sergio-isidoro/PUFA/Projeto_completo_IMG-video.png

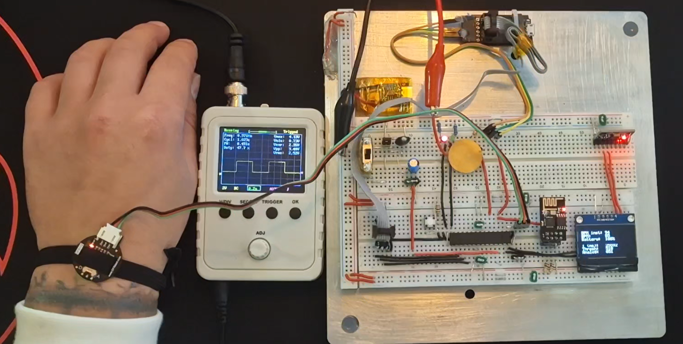
Projeto_completo_IMG-video.png
