sergio-isidoro/PUFA/oledsh1106.jpg

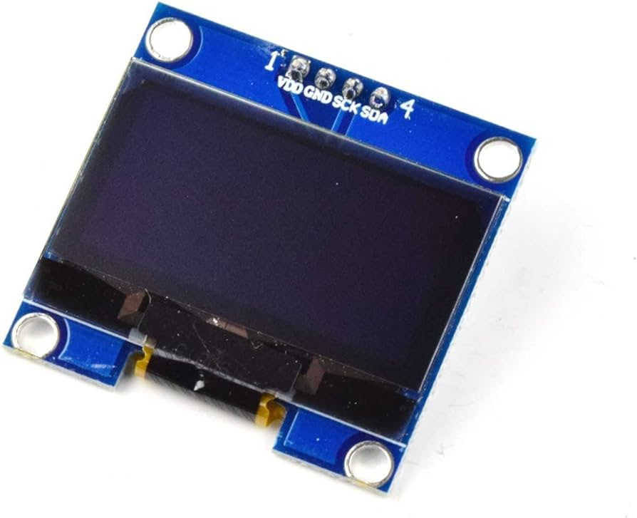
oledsh1106.jpg
