sergio-isidoro/PUFA/README.md

# 🔥 PUFA

yet to be described!

## Screenshot's

Arquitectura
Circuito
Captura de tela 2025-01-09 114456
PCB_FRONT
PCB_BACK

## Photos

Projeto_completo

## Video

https://github.com/user-attachments/assets/bb75e299-b183-4e6a-995e-6fe85692a9c1

## Github link

[PUFA](https://github.com/manoper93/PUFA)
