sergio-isidoro/PUFA/battery.pdf

09/12/2021

1

1

## POWER SUPPLY ALTERNATIVES IN ELECTRONIC SYSTEMS

Systems Laboratory (LABSI)

December 2021

Lino Sousa

LABSI – Systems Laboratory

2

## Summary

### 1. Introduction

### 2. Battery characteristics

### 3. SOC estimation

### 4. Battery technologies

### 5. Power management

LABSI – Systems Laboratory

2

3

## Summary

### 1. Introduction

### 2. Battery characteristics

### 3. SOC estimation

### 4. Battery technologies

### 5. Power management

LABSI – Systems Laboratory

## Introduction

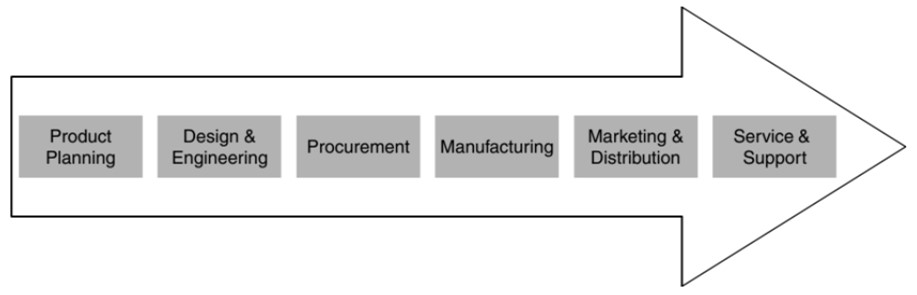
[picture p26: figure]

## Design and development of electronic mobile devices

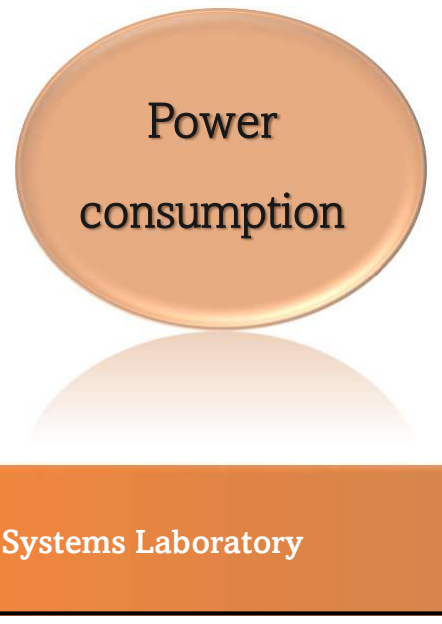
[picture p27: figure]
Power consumption
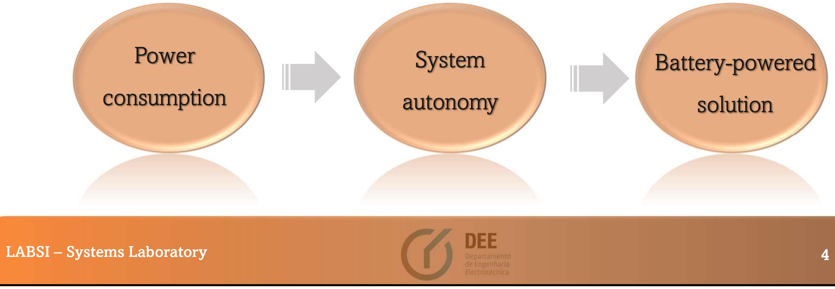
[picture p28: figure]
LABSI – Systems Laboratory; System autonomy; Battery-powered solution
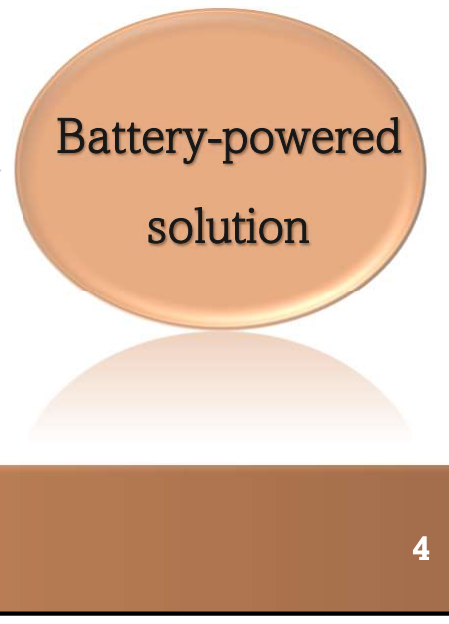
[picture p29: figure]

3

LABSI – Systems Laboratory | 5

## Introduction

## Power Budget

Determines where all the
possible power will be used by a device by breaking it down into components and categories
Components | Voltage | Current | Power | Qt. | Total Power
Atmega 328 | 5 V | 16 mA | 80 mW | 2 | 160 mW
LED | 2 V | 8 mA | 16 mW | 4 | 64 mW
DS18S20 Digital Termometer | 5 V | 2 mA | 10 mW | 1 | 10 mW
APC220 Wireless Radio Module | 5 V | 30 mA | 150 mW | 1 | 150 mW
GY87 Inertial Measurement Unit | 5 V | 4 mA | 20 mW | 1 | 20 mW
DHT11 Humidity Sensor | 5 V | 3 mA | 15 mW | 1 | 15 mW
SD-Card Module | 5 V | 50 mA | 250 mW | 1 | 250 mW
OV7670 CMOS Camera | 3 V | 20 mA | 60 mW | 1 | 60 mW
BMP180 Altitude Sensor | 2,5 V | 2 mA | 5 mW | 1 | 5 mW
GPS Module | 3,3 V | 70 mA | 231 mW | 1 | 231 mW
Total | – | 205 mA | 837 mW | 14 | 965 mW

Example for a drone module with • Position/attitude tracking and

control • Environment data acquisition

Total current: 245 mA

LABSI – Systems Laboratory | 6

## Introduction

## Calculating battery capacity

Power Budget | Current | Power | Qt. | Total Power
Total | 245 mA | 837 mW | 13 | 965 mW

Maximum current consumption over a period of time

C = I × t

- Our system has a maximum current consumption of I
- We want the system to run for t hours straight. • We can then obtain the battery

minimum capacity in Ampere ∙ hour

If we want our system to continuously run for 40 hours, the battery minimum capacity comes:
C = 0,245 × 40 = 9,8 A∙h

Previous application example (Drone Module)

4

LABSI – Systems Laboratory | 7

## Introduction

## Calculating battery capacity

What if the power consumption is not constant ?

I = 20 ×

1
3600 + 0,5 ×

3599
3600 = 0,505 A
- Determine the average current or power consumption per hour • Consider a repetitive cycle of 1 hour

Example: a system has a current consumption of

### 20 A in the first second, and 0,5 A for the rest of

the hour. The average current consumption is:

LABSI – Systems Laboratory | 8

## Introduction

## Calculating battery capacity

Battery lifecycle considerations

C

=

C
0,8
- It is not advised to completely discharge a battery during a cycle • Example: a lead acid battery charge should never be less than

20% of the total charge, to increase its life-cycle • However, some battery technologies, such as NiCd can be

discharged to 100%

5

9

## Summary

### 1. Introduction

### 2. Battery characteristics

### 3. SOC estimation

### 4. Battery technologies

### 5. Power management

LABSI – Systems Laboratory

10

## Battery Characteristics

LABSI – Systems Laboratory

Capacity • Capacity is a measure of the battery charge in Amp ∙ h • Represents the maximum amount of energy that can be extracted from the battery in a specific time interval • Installing a battery with a higher capacity results in a longer runtime, affecting the system’s autonomy • The charging time of a battery with high capacity will take longer that a battery with lower capacity

### 1 Coulomb = 1 A s

6

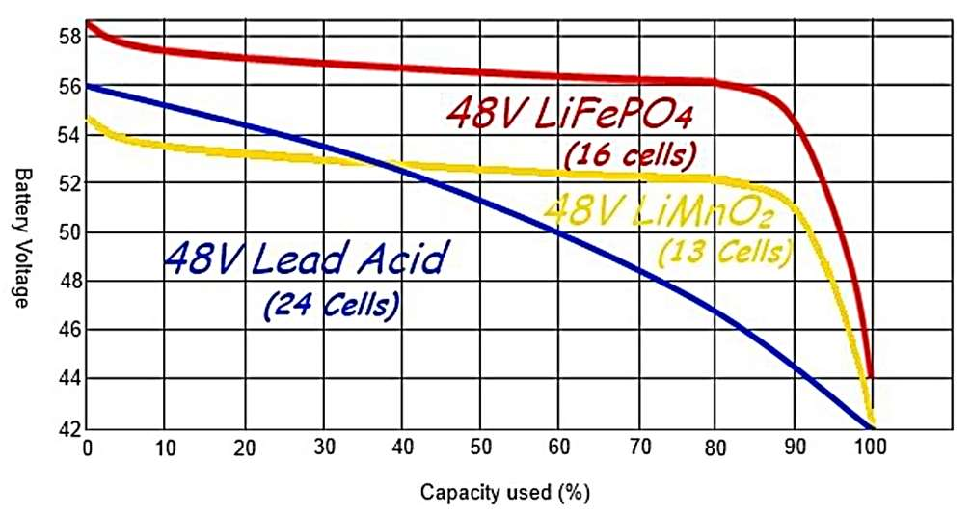
[picture p30: figure]

11

## Battery Characteristics

LABSI – Systems Laboratory

Nominal Voltage • Nominal voltage is determined by

chemical reactions that involve the flow of electrons from one material (electrode) to another • This flow of electrons generates an

electrical current • The battery voltage is a function that

changes with the charge level, meaning that the nominal voltage should always be checked before connecting the battery

Battery voltage curve for: • Lead Acid Batteries • Lithium Iron Phosphate Batteries • Lithium Manganese Dioxide Batteries

12

## Battery Characteristics

LABSI – Systems Laboratory

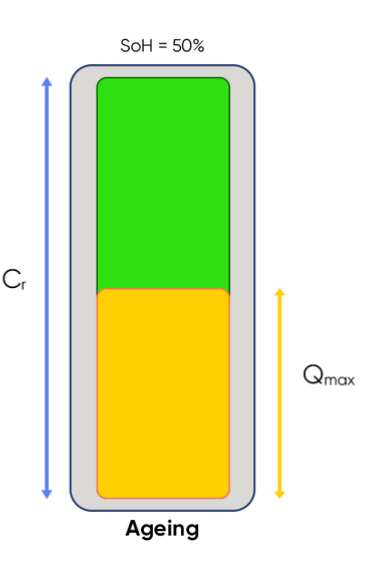
[picture p31: figure]

## State of Health – SoH

- The SoH of a battery describes the difference between a battery being studied and a fresh battery. • It considers the cell aging parameter. • It is defined as the ratio of the maximum battery

charge to its rated capacity

7

13

## Battery Characteristics

LABSI – Systems Laboratory

State of Charge – SoC • The SoC of a battery describes the difference between

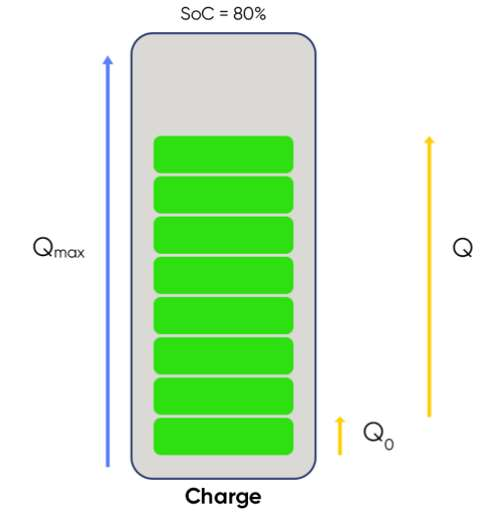
[picture p32: figure]

a fully charged battery and the same battery in use • It is associated with the remaining quantity of

electricity available in the cell • It is defined as the ratio of the remaining charge in the

battery, divided by the maximum charge that can be delivered by the battery.

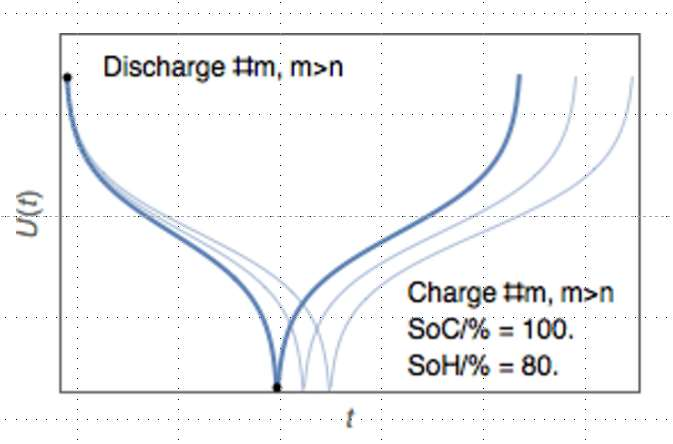
[picture p33: figure]

14

## Battery Characteristics

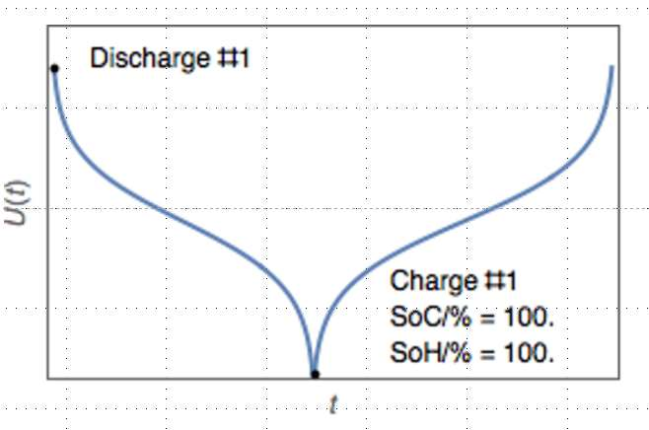
[picture p34: figure]

LABSI – Systems Laboratory

SoC and SoH relation • The discharge profile of a secondary battery is affected by its state of health • The lower the SoH, the faster the battery is discharged/charged

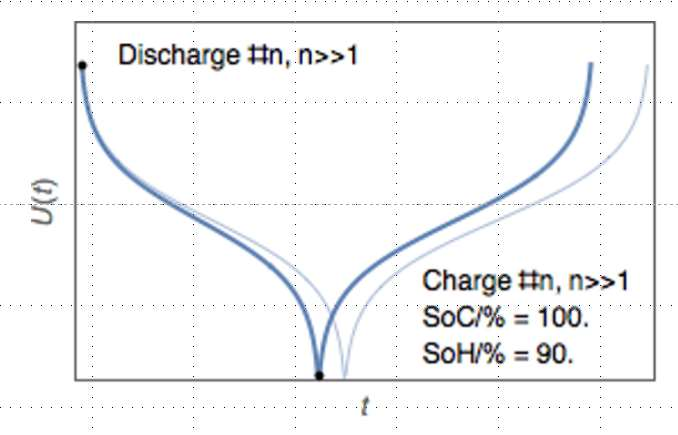
[picture p35: figure]

8

15

## Battery Characteristics

LABSI – Systems Laboratory

## Charging / Discharging rates

Represent the battery capacity as a function of the time in which it takes to fully discharge or charge the battery

The notation to specify battery capacity in this way is written as Cx, where x is the time in hours that it takes to discharge the battery

Cx

Example:

- C20 battery (or 0.05C)
- Capacity of 500 Ah

Discharge rate:

500 Ah / 20 h = 25 A

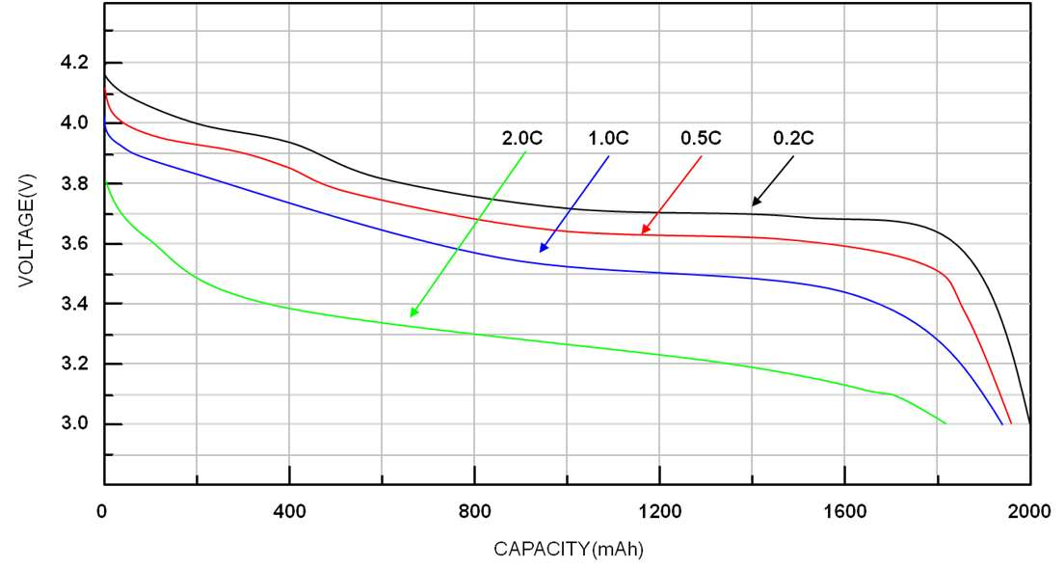
[picture p36: figure]

16

## Battery Characteristics

LABSI – Systems Laboratory

Charging / Discharging rates • Flat discharge curves: the battery

voltage remains constant throughout the discharge cycle • Sloping discharge curves: the battery

voltage is closely related to the remaining charge in the cell • Flat discharge curves require more

complex methods of estimating SoC

Discharge curves for a Li-ion battery

9

17

## Battery Characteristics

LABSI – Systems Laboratory

Self-discharge • Even in the absence of a connected load, the

discharge reaction will proceed to a limited extent • This means the battery will discharge itself

over time • The self-discharge rate depends on: o The materials involved in the chemical

reaction o The temperature of the battery

Battery | Self-discharge
Lithium metal | 10 years
Alkaline | 5 years
Zinc–carbon | 2–3 years
Lithium-ion | 2–3% per month
Lithium-polymer | 5% per month
Lead–acid | 4–6% per month
Nickel–cadmium | 15–20% per month
Nickel–metal hydride (NiMH) | 30% per month

Typical self-discharge by battery type

18

## Battery Characteristics

LABSI – Systems Laboratory

Battery lifetime • Involves gradual degradation in battery capacity • Typically given as the number of charge/discharge cycles which it

can undergo and still maintain its original capacity • In systems such as in uninterruptable power supplies, battery lifetime

### is more appropriately specified in years

10

19

## Summary

### 1. Introduction

### 2. Battery characteristics

### 3. SOC estimation

### 4. Battery technologies

### 5. Power management

LABSI – Systems Laboratory

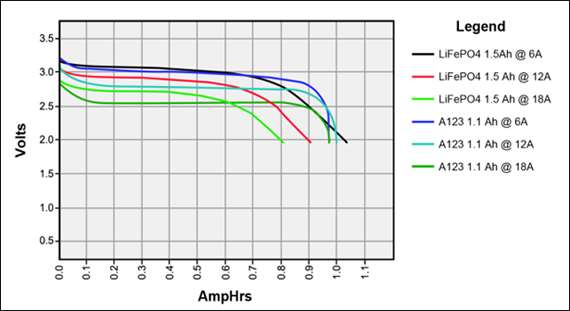
[picture p37: figure]

20

## SoC Estimation

LABSI – Systems Laboratory

## Voltage Method

Measuring state-of-charge by voltage is the simplest method, but it can be inaccurate

The battery needs to rest in the open circuit
state for at least four hours

Some discharge curves are very flat during approximately 80% of the discharge.

Cell materials and temperature affect the voltage at the battery terminals

Li-phosphate (LiFePO) batteries discharge profile

11

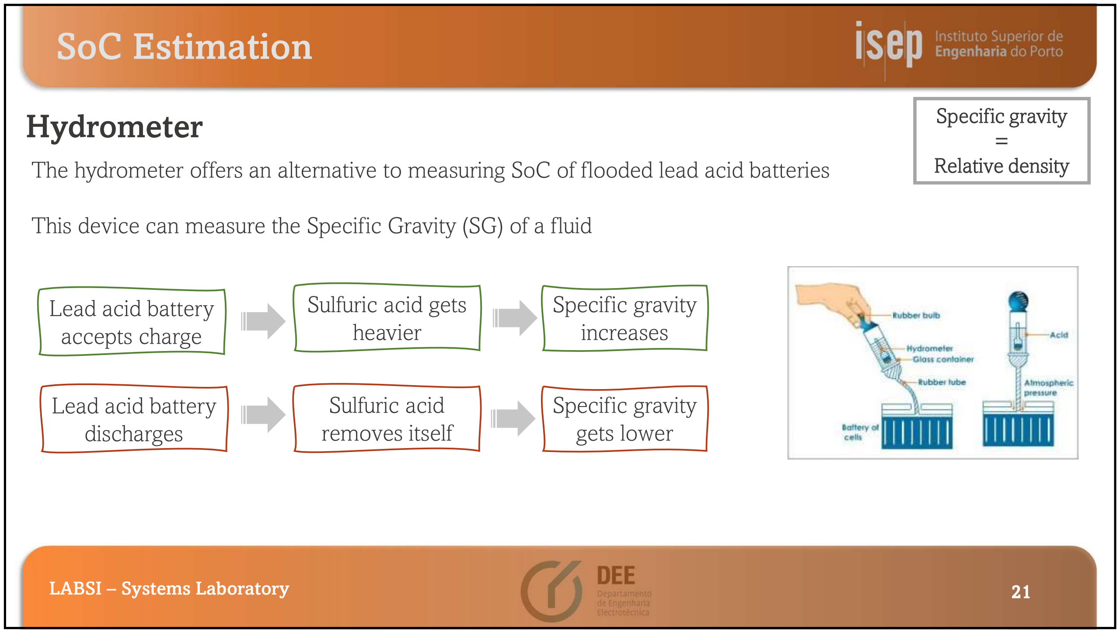
[picture p38: figure]
SoC Estimation; LABSI – Systems Laboratory; Hydrometer; Lead acid battery accepts charge; Sulfuric acid gets heavier; Specific gravity increases; Specific gravity =; Relative density; Lead acid battery discharges; Sulfuric acid removes itself; Specific gravity gets lower

The hydrometer offers an alternative to measuring SoC of flooded lead acid batteries

This device can measure the Specific Gravity (SG) of a fluid

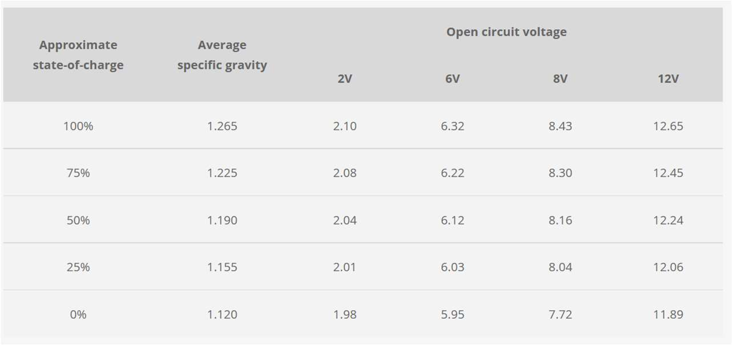
[picture p39: figure]

22

## SoC Estimation

LABSI – Systems Laboratory

## Hydrometer

Temperature alters the
specific gravity reading

The electrolyte needs to
stabilize after charge/discharge before taking the SG reading

The SG of the same battery in full charge or discharge may vary from 1.270 to 1.305 and 1.097 to 1.201 respectively

12

23

## SoC Estimation

LABSI – Systems Laboratory

Coulomb counting • Coulomb counting estimates SoC

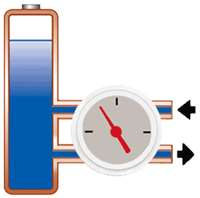
[picture p40: figure]

by measuring the in-and-out-flowing current • This method is used by most

laptops, medical equipment and other professional portable devices to estimate SoC • How it works: a circuit measures

the in-and-out flowing energy; the stored energy represents state-of-charge

Since losses occur, the available energy is always less than what has been fed into the battery

Requires periodical calibration to estimate how much energy the battery delivered during previous discharge

24

## SoC Estimation

LABSI – Systems Laboratory

## So, how do we exactly now I much battery we have left ?

### Short answer: We don’t … Nothing in the battery world is absolute

We can combine this methods and
create algorithms in order to efficiently
estimate the battery state-of-charge | • Kalman Filtering • Pressure method • Electrical Impedance Spectroscopy • Neural Networks • Support Vector Machines
Solution | Other methods:

13

25

## Summary

### 1. Introduction

### 2. Battery characteristics

### 3. SOC estimation

### 4. Battery technologies

### 5. Power management

LABSI – Systems Laboratory

26

## Battery Technologies

LABSI – Systems Laboratory

## General considerations

The most common battery technologies are: • Lead Acid (PbAc) • Nickel-cadmium (NiCd) • Nickel-Metal Hydrite (NiMH) • Lithium Polymer (LiPo)

Most of these rechargeable batteries show a voltage level of 10 to 15 % superior to the nominal voltage when fully charged

Warning:

Series/parallel disposal of batteries result in different voltage levels and capacities. • Lead Acid: 2 V per cell • NiCd and NiMh: 1,2 V per cell • LiPo and Li-Ion: 3,7 V per cell

Multiple batteries are often combined to produce desirable voltage levels or higher capacities

14

27

## Battery Technologies

LABSI – Systems Laboratory

## Battery comparison

Lead Acid | NiCd | NiMH | LiPo • Usually found in cars, boats,

solar energy systems • Large and heavy • Highest capacities: 5 – 150 Ah • Typically available in 6, 8, 12

and 24 V • Solution for electronics: deep-

cycle and sealed batteries

- Usually applied as supply to small electrical motors • Long lifetime with thousands

of charging cycles • High self-discharging rate • Low energy density • Not suitable for mobile

devices

- High capacity 1 – 4
Ah for its size • Fairly high self-

discharging rate • High energy

density • Used in mobile

devices

- One of the most recent
technologies • High energy density • Flexible in size and shape for

a variety of applications • High capacity up to 5Ah • Require specific cautions to

avoid overheating

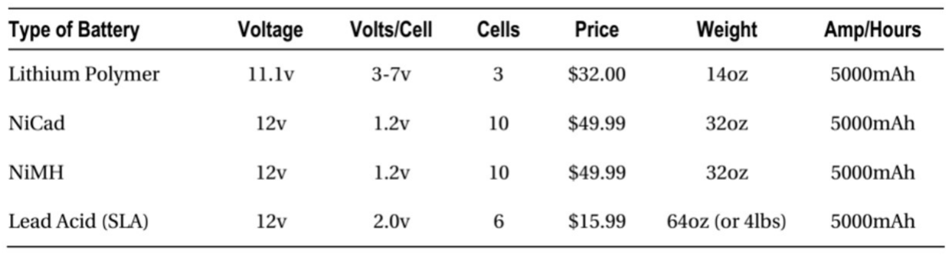
[picture p41: figure]
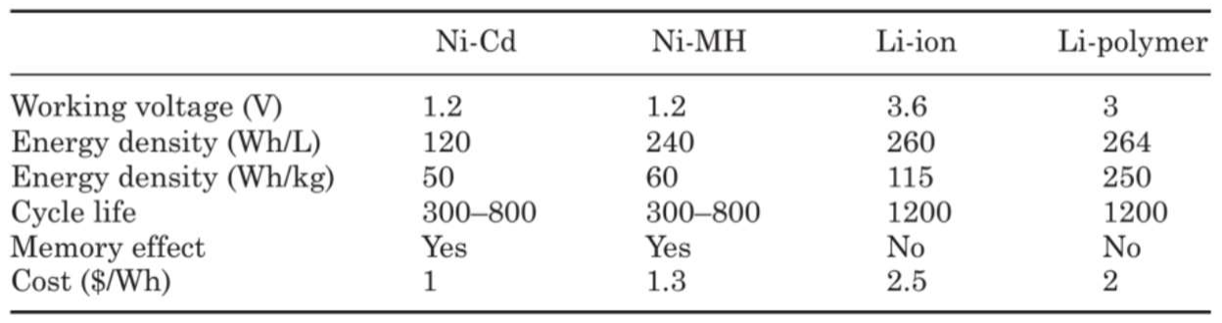
[picture p42: figure]

28

## Battery Technologies

LABSI – Systems Laboratory

## Battery comparison

- LiPo batteries have the highest energy density • Lead acid batteries are the cheapest • NiCd and NiMH are suitable for

most electronic projects • LiPo batteries are the lightest

Each battery technology has its own advantages depending on the application

15

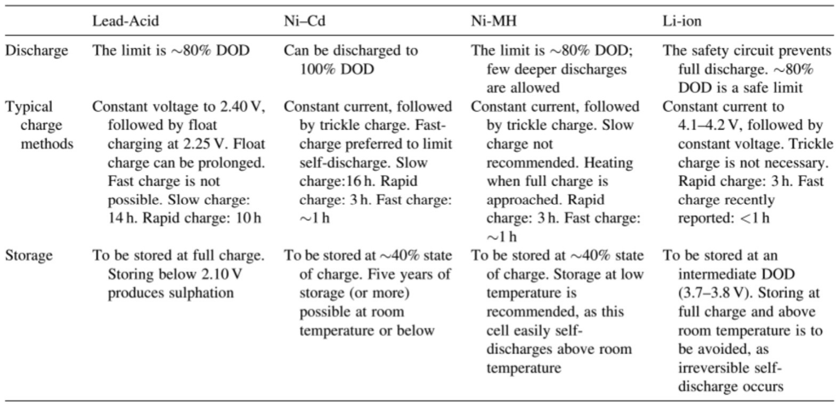
[picture p43: figure]

29

## Battery Technologies

LABSI – Systems Laboratory

## Battery comparison

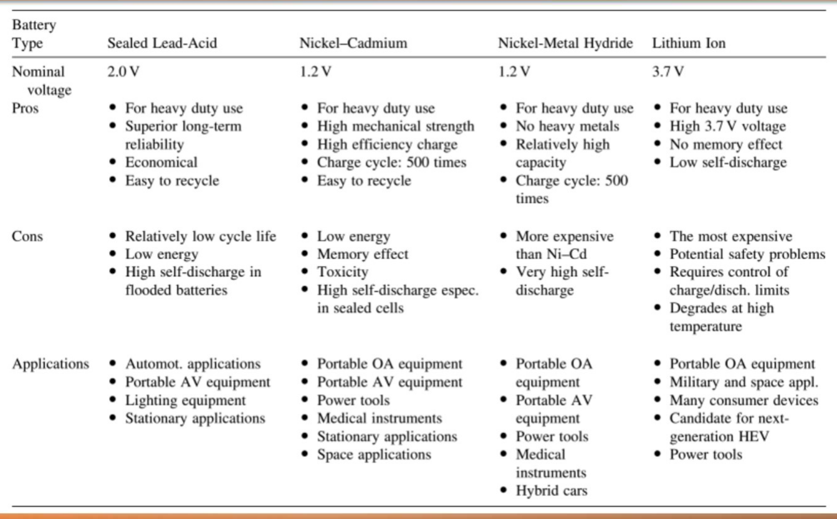
[picture p44: figure]

30

## Battery Technologies

LABSI – Systems Laboratory

## Battery comparison

16

31

## Summary

### 1. Introduction

### 2. Battery characteristics

### 3. SOC estimation

### 4. Battery technologies

### 5. Power management

LABSI – Systems Laboratory

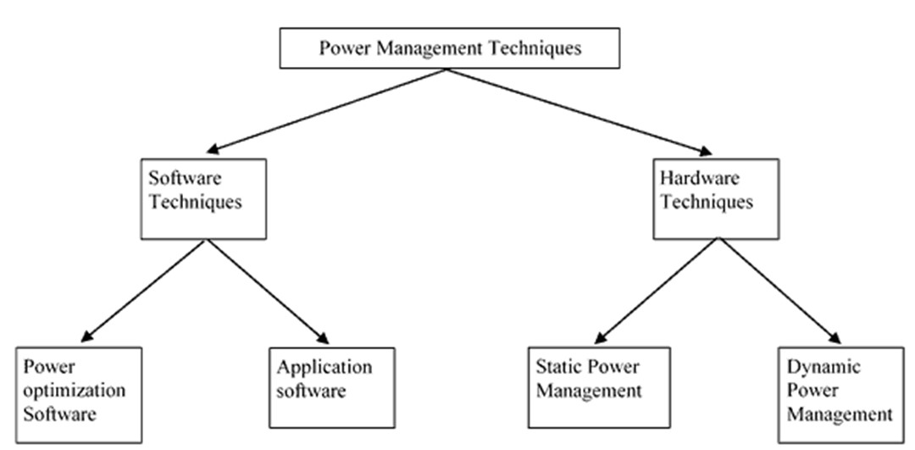
[picture p45: figure]

32

## Power management

LABSI – Systems Laboratory

## Power management

Process of controlling power use in a system by hardware or software

- Battery life improvement
- System’s autonomy increase
- Better thermal behaviour
- Noise reduction
- Improved reliability (better MTBF)

MTBF: Mean time between failure

17

33

## Power management

LABSI – Systems Laboratory

## Power management techniques

Dynamic voltage and
frequency scaling
Automatic adaption of
CPU | frequencies | and
voltages according to the
system load.
The lower the frequency of operation, the lower the
power consumption

Peripheral Power-down

Peripherals and subsystems may be switched on and off
by | the | software, | as
required.
This applies to TIMERs,
ADCs, SPI, I2C and similar components

Low power modes
When a device is not in use, it may be switched to a low power state: • Standby: The CPU and peripherals are

shut down, but power is maintained. Wakes up faster. • Hibernate: The system is shut down and

Timers are disabled. CPU has nothing to run, so there is no ongoing power drain

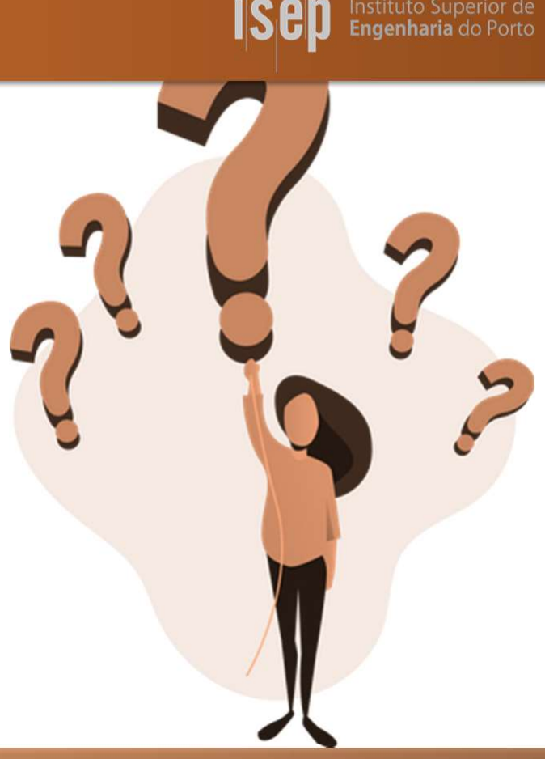
[picture p46: figure]

34

## Questions

LABSI – Systems Laboratory

# Thank you

# For your attention
