sergio-isidoro/PUFA/atmega328p.png

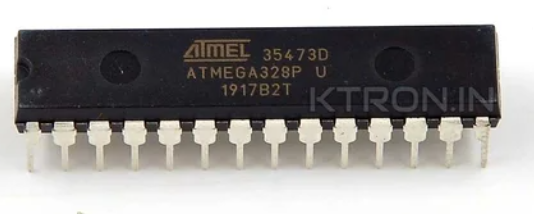
atmega328p.png
