sergio-isidoro/PUFA/Atmega328p_pinout.png

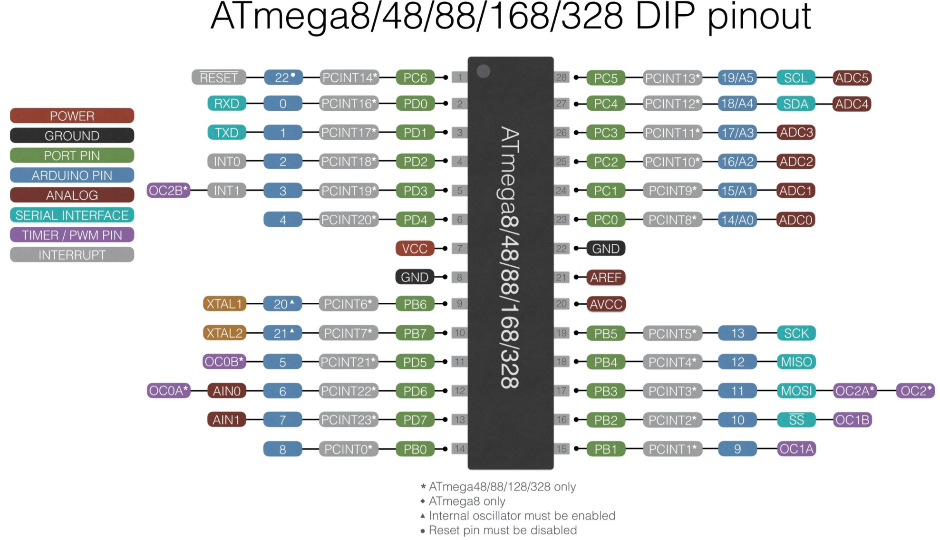
Atmega328p_pinout.png
