sergio-isidoro/PUFA/bateria-recarregavel-li-po-3-7v-1200mah.jpg

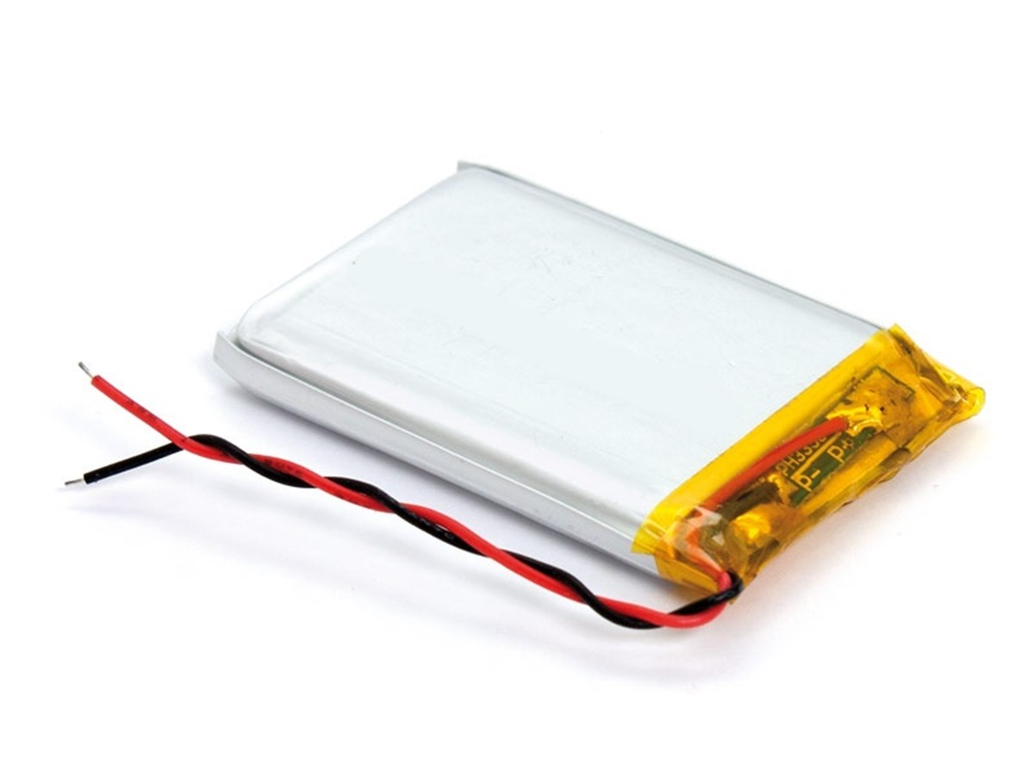
bateria-recarregavel-li-po-3-7v-1200mah.jpg
