sergio-isidoro/PUFA/buzzer-piezo.jpg

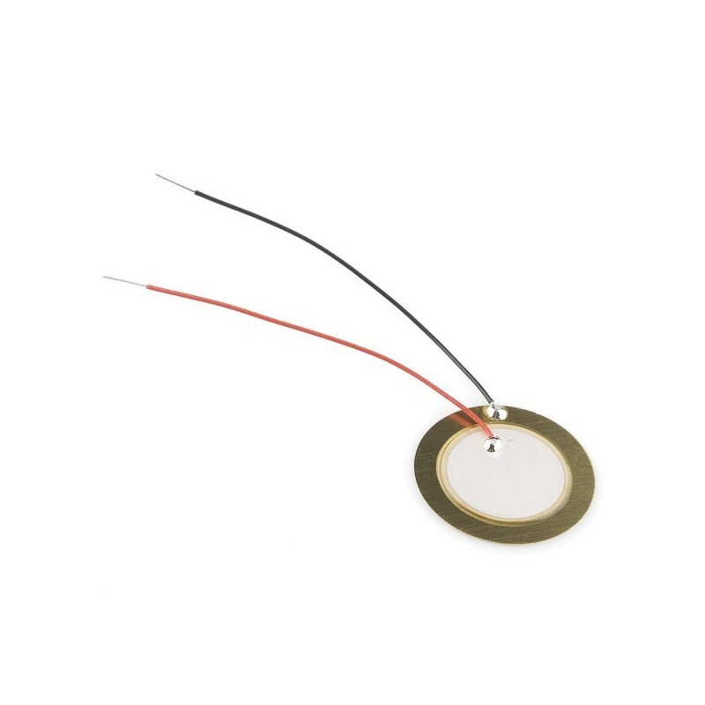
buzzer-piezo.jpg
