sergio-isidoro/PUFA/circuito.png

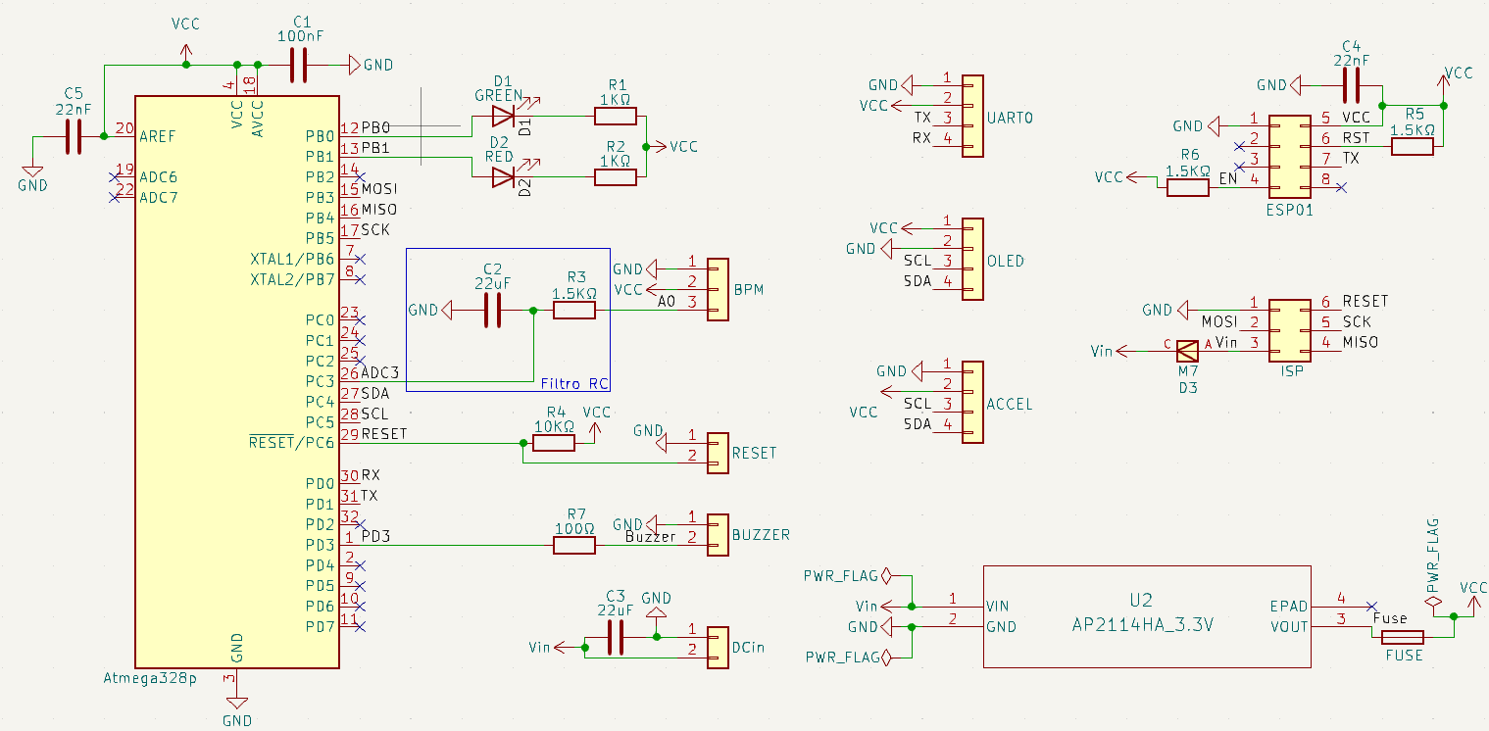
circuito.png
