sergio-isidoro/PUFA/circuito_regulador.png

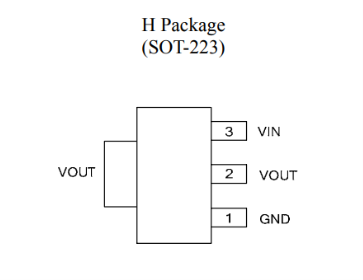
circuito_regulador.png
