sergio-isidoro/PUFA/cyplus.png

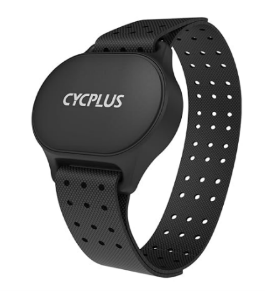
cyplus.png
