sergio-isidoro/PUFA/esense.png

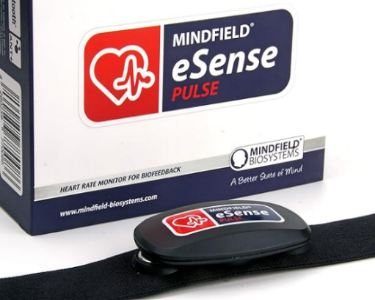
esense.png
