sergio-isidoro/PUFA/Filtro_RC_ADC.jpg

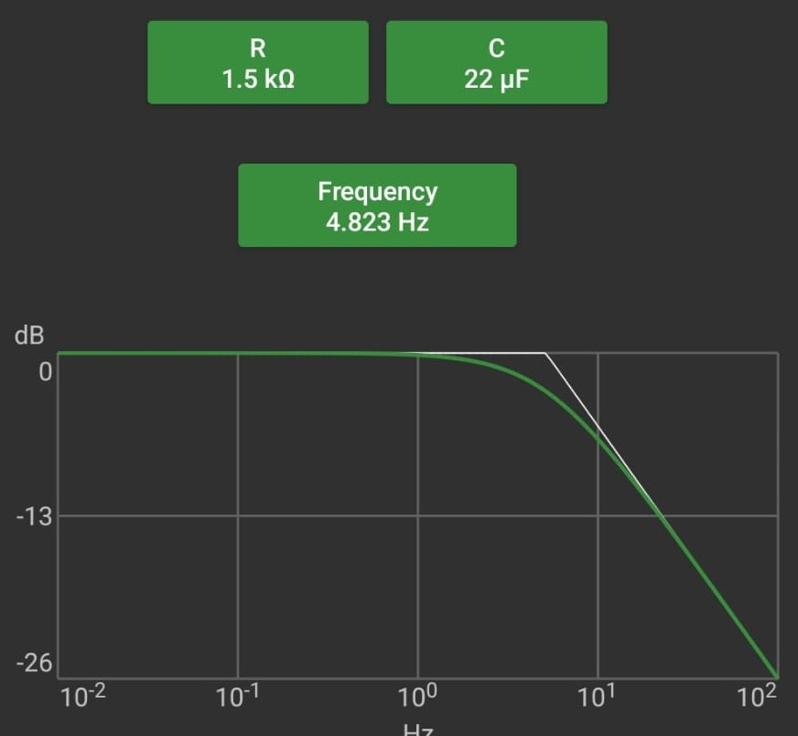
Filtro_RC_ADC.jpg
