sergio-isidoro/PUFA/Fluxograma_Software_Apresnetação.png

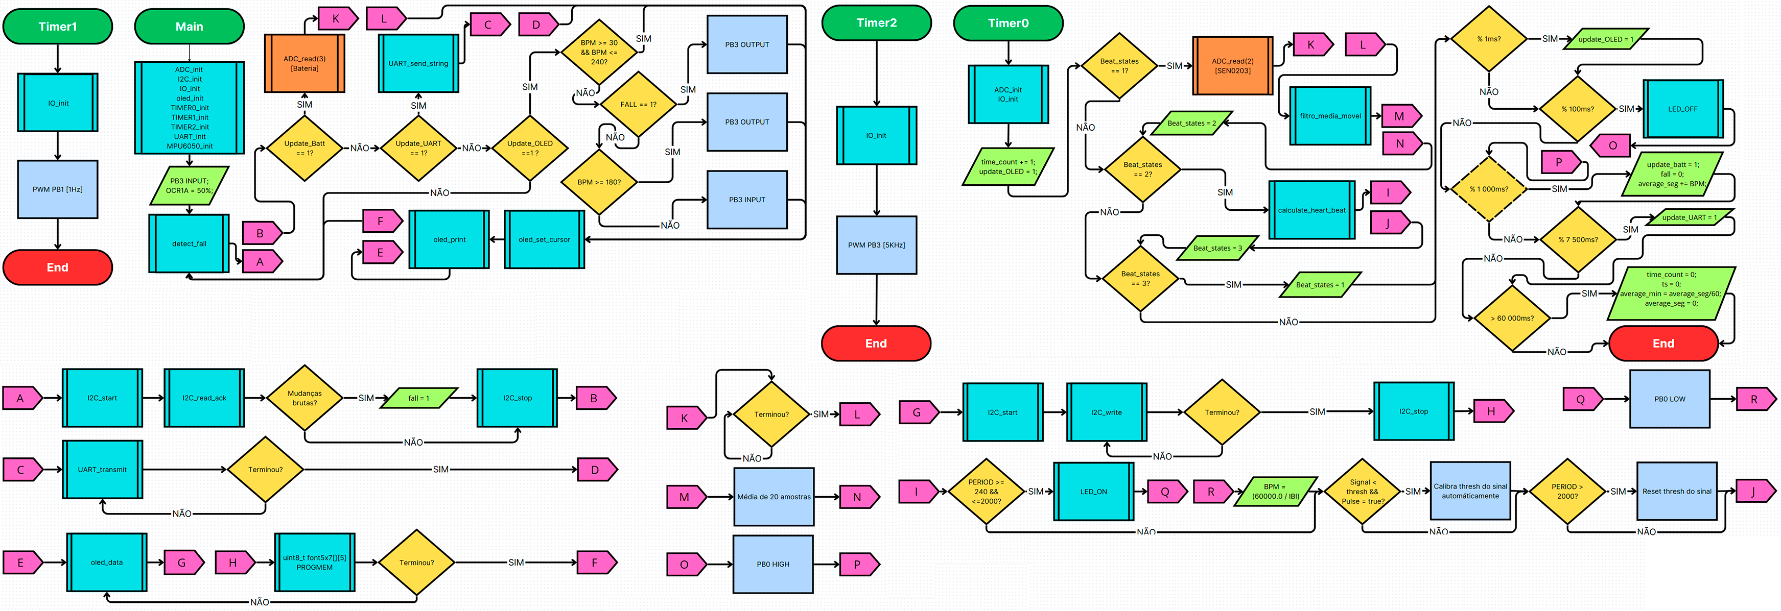
Fluxograma_Software_Apresnetação.png
