sergio-isidoro/PUFA/led´s.jpg

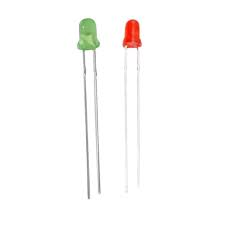
led´s.jpg
