sergio-isidoro/PUFA/modulo_wifi_esp01.png

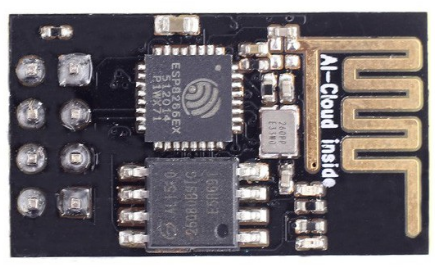
modulo_wifi_esp01.png
