sergio-isidoro/PUFA/oledsh1106_circuit.png

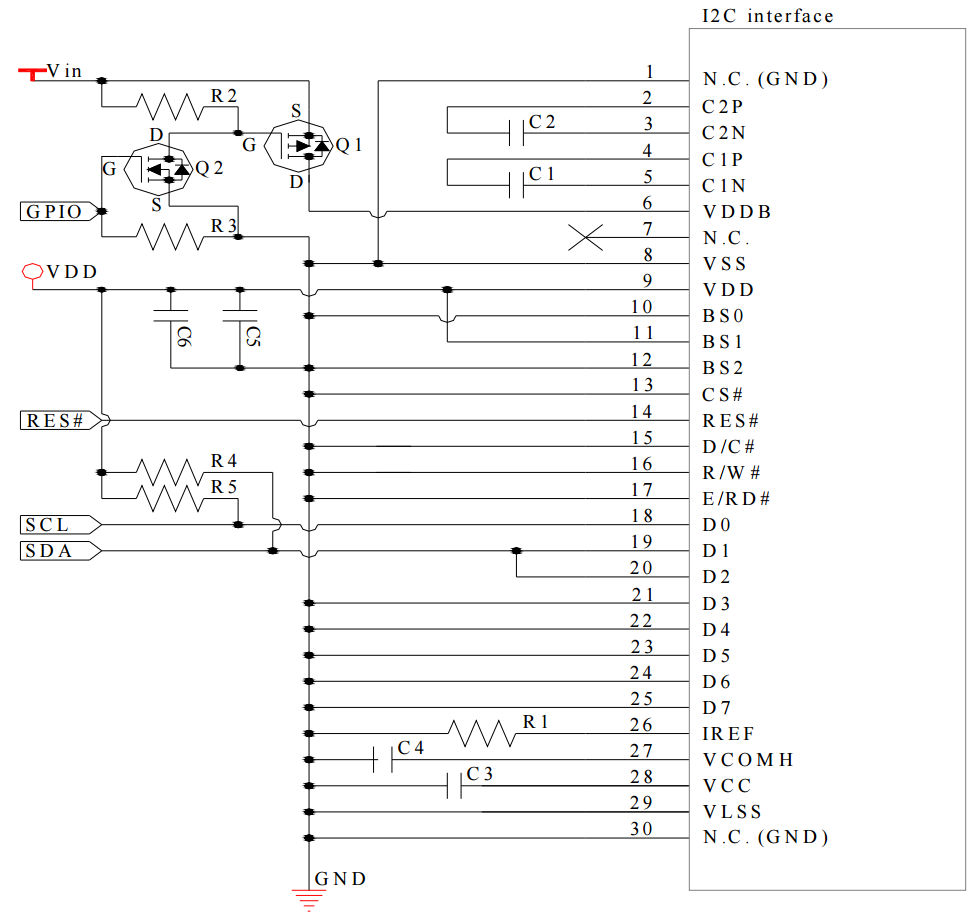
oledsh1106_circuit.png
