sergio-isidoro/PUFA/Projeto_completo.jpg

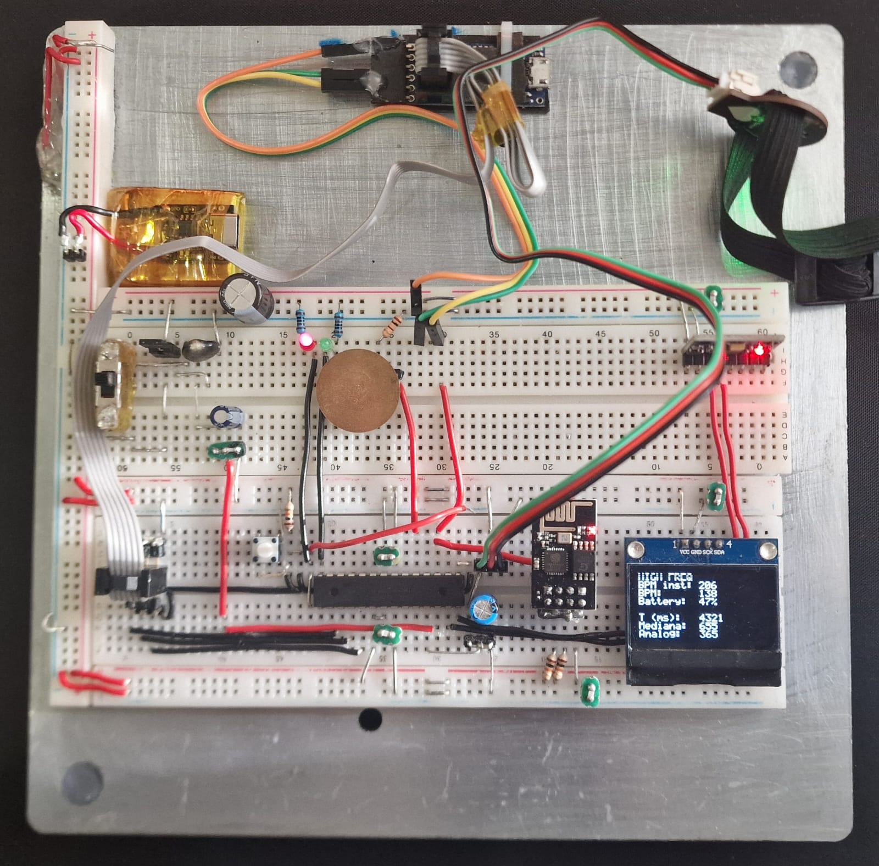
Projeto_completo.jpg
