sergio-isidoro/PUFA/PUFA.png

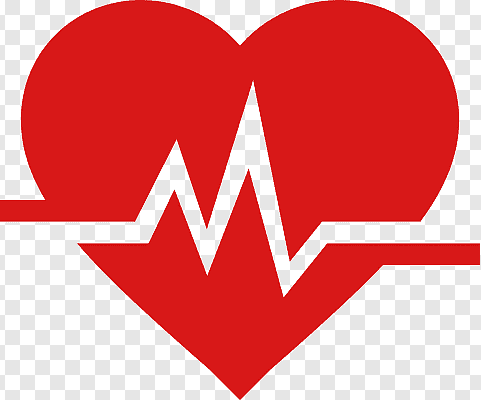
PUFA.png
