sergio-isidoro/PUFA/SEN0203.jpg

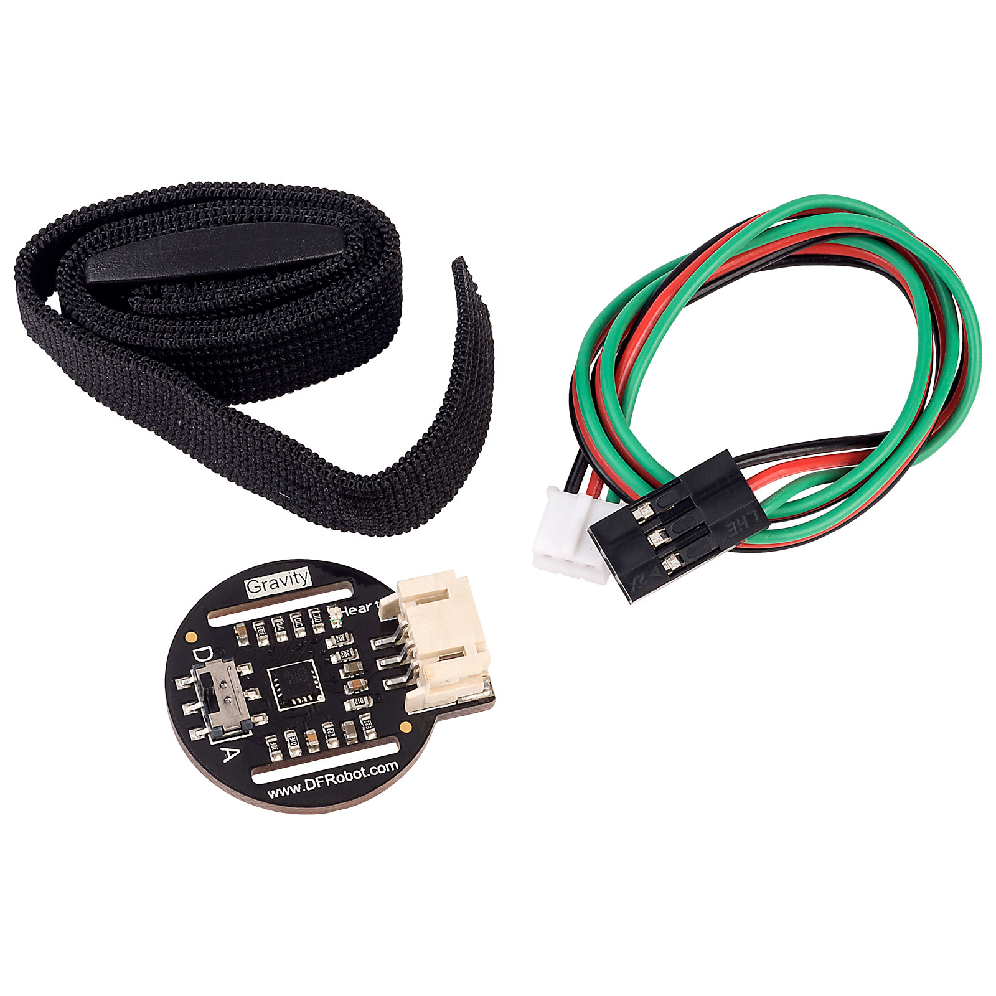
SEN0203.jpg
