sergio-isidoro/PUFA/PUFA_KICAD/Adds/M7/M7.step

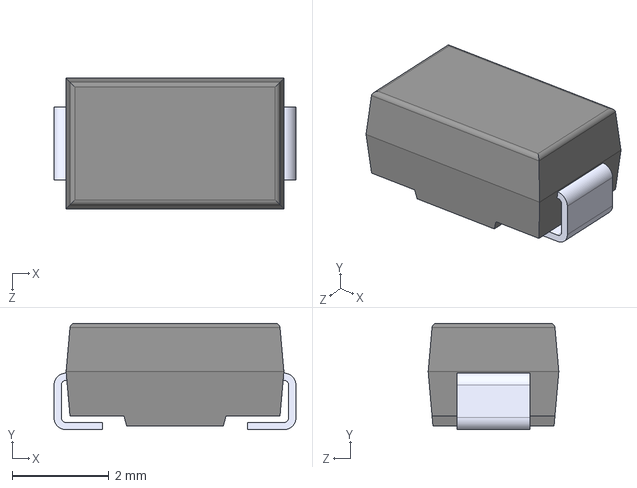
[picture p63: CAD file, 2025-01-09]
PUFA_KICAD/Adds/M7/M7.step
5.00 x 2.20 x 2.70 mm
