sergio-isidoro/PUFA/PUFA_KICAD/PUFA.kicad_pcb

## KiCad design PUFA_KICAD/PUFA.kicad_pcb (2025-01-09)

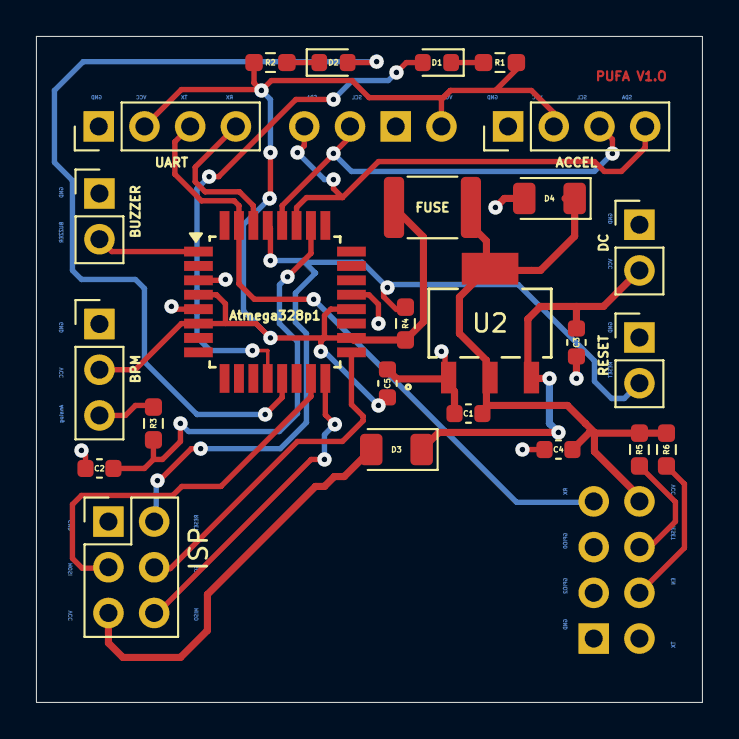
[picture p64: board PUFA.kicad_pcb from above]

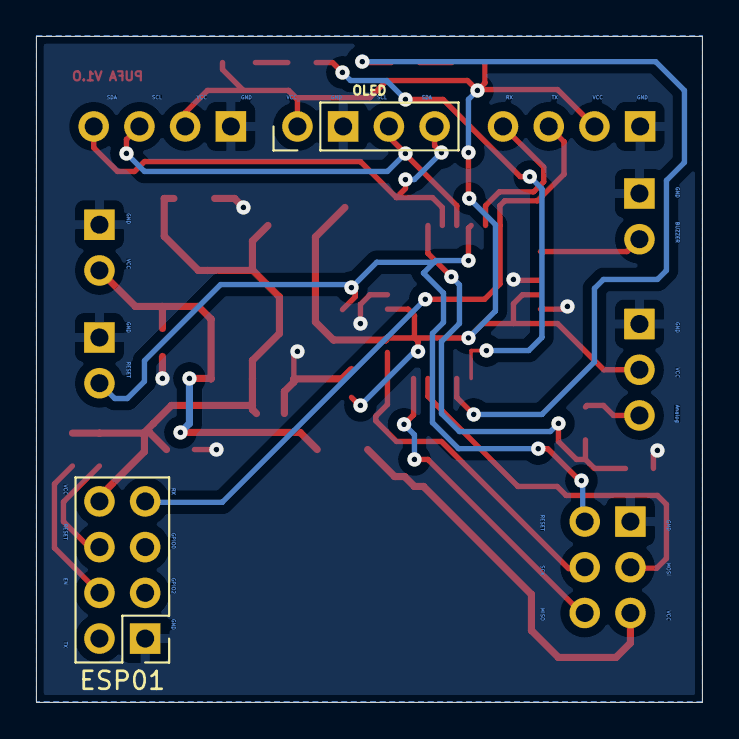
[picture p65: board PUFA.kicad_pcb from below]

Board: 2 copper layers, 37.0 x 37.0 mm, 27 parts (2 on the bottom side), 15 nets.

Parts:
ACCEL: PinHeader_1x04_P2.54mm_Vertical
Atmega328p1: ATmega328P-A; TQFP-32_7x7mm_P0.8mm
BPM: PinHeader_1x03_P2.54mm_Vertical
BUZZER: PinHeader_1x02_P2.54mm_Vertical
C1, C2, C3, C4, C5: C_0603_1608Metric
D1, D2: LED_0603_1608Metric
D3, D4: D_1206_3216Metric
DC: PinHeader_1x02_P2.54mm_Vertical
ESP01: PinHeader_2x04_P2.54mm_Vertical
FUSE: Fuse_1812_4532Metric
ISP: PinHeader_2x03_P2.54mm_Vertical
OLED: PinHeader_1x04_P2.54mm_Vertical
R1, R2, R3, R4, R5, R6: R_0603_1608Metric_Pad0.98x0.95mm_HandSolder
RESET: PinHeader_1x02_P2.54mm_Vertical
U2: AP2114HA_3.3V; SOT-223_DIO
UART: PinHeader_1x04_P2.54mm_Vertical

Connections:
/ADC3: Atmega328p1.26 (PC3), BPM.3, C2.1, R3.1, R3.2
/MISO: Atmega328p1.16 (PB4), ISP.6
/MOSI: Atmega328p1.15 (PB3), ISP.3
/PB0: Atmega328p1.12 (PB0), D1.2
/PB1: Atmega328p1.13 (PB1), D2.2
/PD3: Atmega328p1.1 (PD3), BUZZER.2
/RESET: Atmega328p1.29 (~RESET/PC6), ISP.2, R4.2, RESET.2
/RX: Atmega328p1.30 (PD0), UART.4
/SCK: Atmega328p1.17 (PB5), ISP.4
/SCL: ACCEL.3, Atmega328p1.28 (PC5), OLED.3
/SDA: ACCEL.4, Atmega328p1.27 (PC4), OLED.4
/TX: Atmega328p1.31 (PD1), ESP01.7, UART.3
GND: ACCEL.1, Atmega328p1.3 (GND), Atmega328p1.5 (GND), Atmega328p1.21 (GND), BPM.1, BUZZER.1, C1.2, C2.2, C3.2, C4.2, C5.2, D4.2, DC.1, ESP01.1, ISP.1, OLED.1, RESET.1, U2.1 (VIN), UART.1
VCC: ACCEL.2, Atmega328p1.4 (VCC), Atmega328p1.6 (VCC), Atmega328p1.18 (AVCC), Atmega328p1.20 (AREF), BPM.2, C1.1, C4.1, C5.1, D4.1, ESP01.8, FUSE.1, FUSE.2, OLED.1, R1.2, R2.1, R4.1, R5.2, R6.1, U2.2 (GND), U2.4 (EPAD), UART.2
Vin: C3.1, D3.1, D3.2, DC.2, ISP.5, U2.3 (VOUT)
