sergio-isidoro/PUFA/Microchip_studio/Adds/TIMER1.h

/*
 * TIMER1.h
 *
 * Sergio Isidoro - 1221709
 * Andre Nogueira - 1221709
 *
 * CHIP: Atmega328p 8MHz
 */

#ifndef TIMER1_H
#define TIMER1_H

#include <avr/io.h>

void TIMER1_init(void);		// Inicialização do PWM no Timer1 (1Hz)

#endif
